aziddy/wifi_rover/media/IMG_20181216_150915.jpg

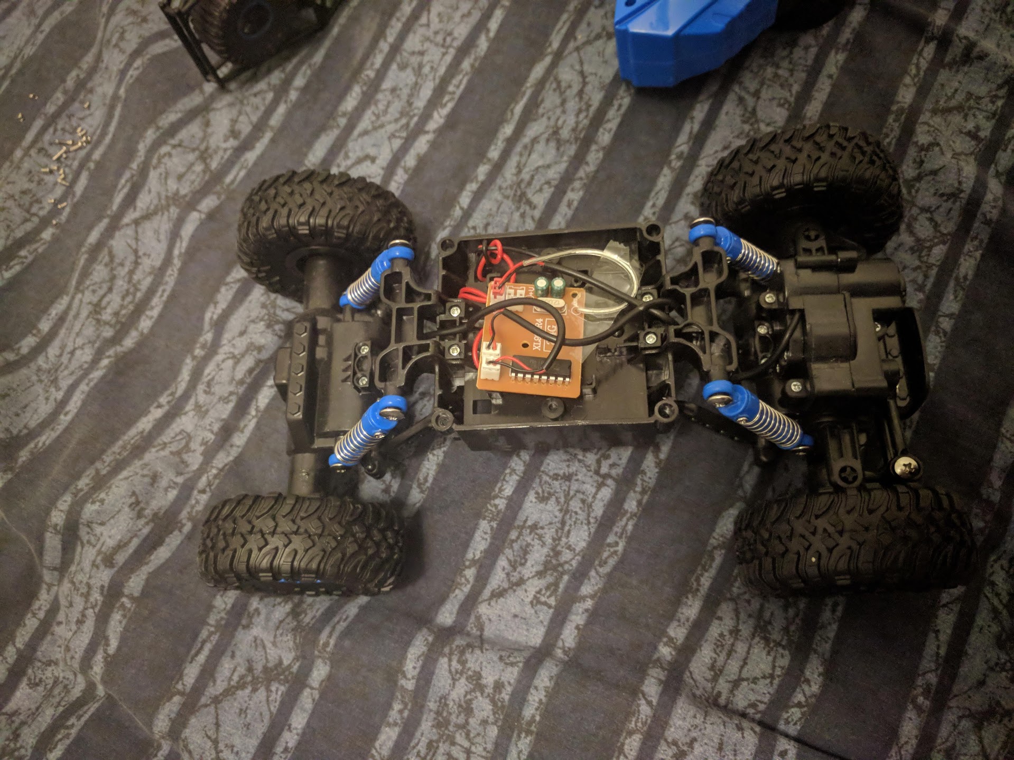
media/IMG_20181216_150915.jpg
