aziddy/wifi_rover/media/IMG_20181216_151211.jpg

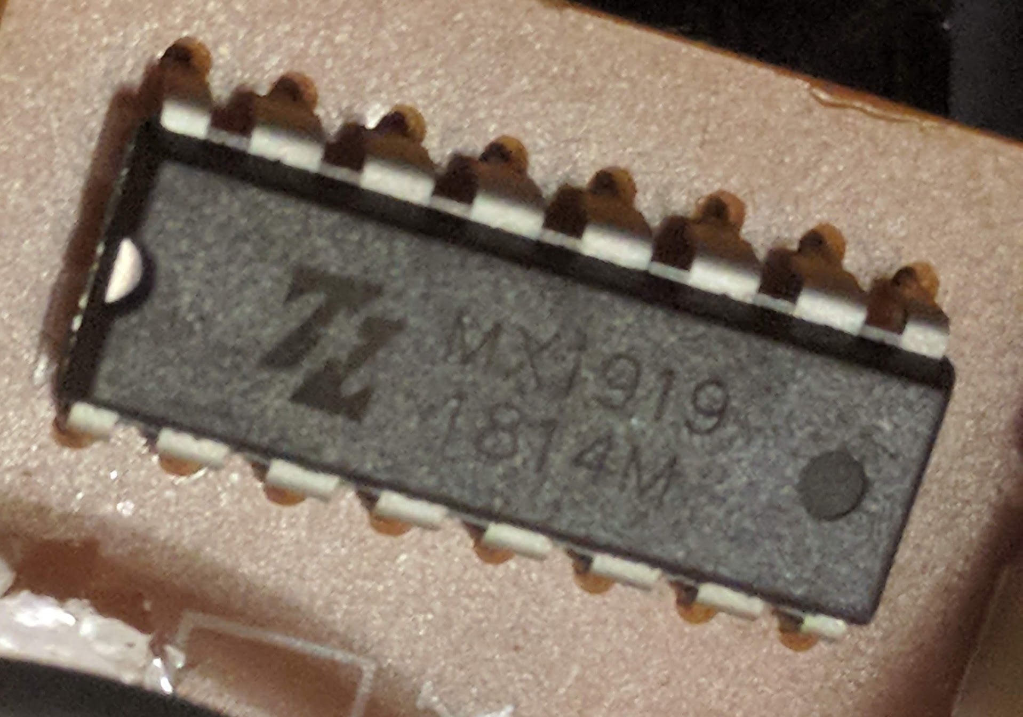
media/IMG_20181216_151211.jpg
