aziddy/wifi_rover/media/IMG_20190103_212330.jpg

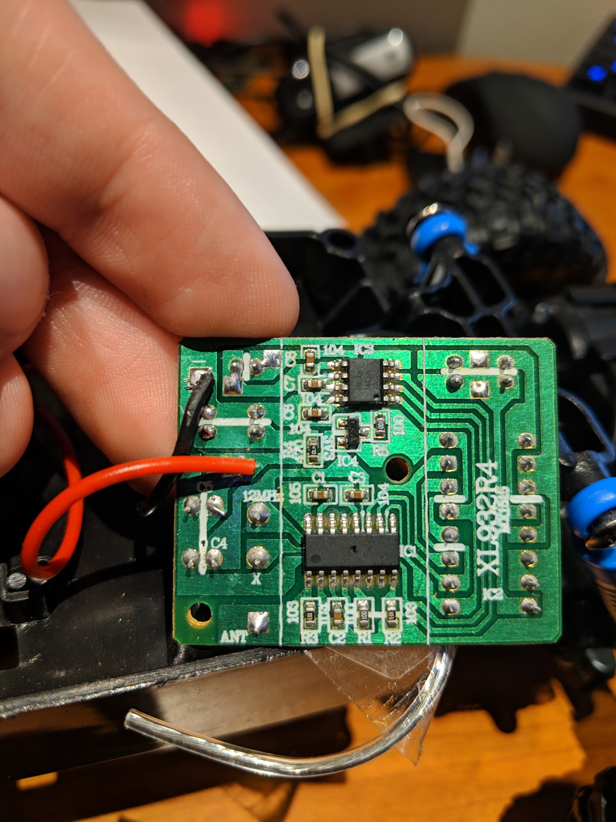
media/IMG_20190103_212330.jpg
