aziddy/wifi_rover/media/IMG_20190103_212419.jpg

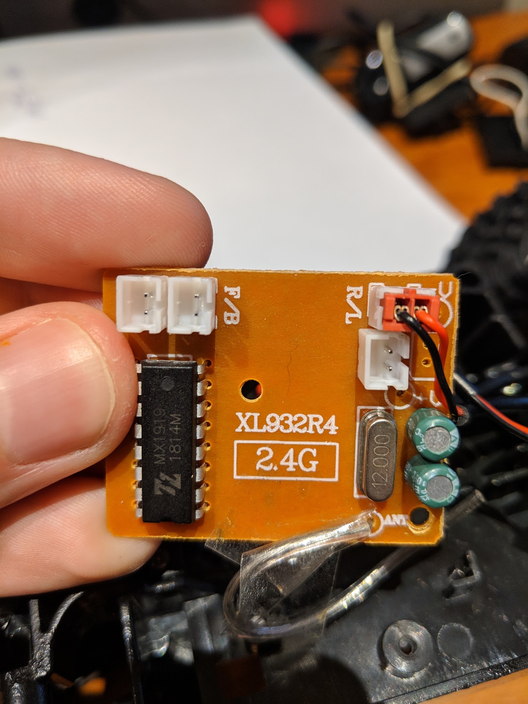
media/IMG_20190103_212419.jpg
