aziddy/wifi_rover/(commit log)

2019-01-10 added serial arduino stuff on rover
2019-01-13 arduino sketch
    arduino sketch
2019-01-16 wiring
    wiring
